MateuszKost/8buttonsQuizBuzzer/Dokumentacja końcowa/Readme.md

Mateusz Kost grupa 4, inf semestr 5

Projekt o nazwie „8 kanałowy dzwonek do quizu” posiadał poniższe założenia:
- informacja wciśniętym guziku (jego numer) będzie adekwatnie wyświetlana na wyświetlaczu
- w przypadku wciśnięcia dwóch guzików, minimalna różnica czasowa przy ich wciskaniu zostanie wychwycona przez program oraz informacja o szybciej wciśniętym guziku zostanie pokazana na wyświetlaczu
- po wychwyceniu wciśnięcia guzika, program wyśle sygnał do buzzera, który zadzwoni

Wersja finalna projektu spełnia wszystkie powyższe założenia, a do samego projektu dołożyłem jeszcze 3 diody sygnalizujące o adekwatnym stanie programu.

Funkcjonalność urządzenia opiera się na wciskaniu jednego z 8 guzików sterujących, a po wyświetleniu informacji na wyświetlaczu na temat wciśniętego guzika należy wcisnąć guzik reset, który wysyła informacje do programu aby zresetował wyświetlacz i pozwolił na ponowną możliwość wciśnięcia guzika sterującego.
