MateuszKost/8buttonsQuizBuzzer/Dokumentacja końcowa/CHANGELOG.md

12 listopada - pierwsza wersja projektu

12 grudnia - zmiana guzików 2 pinowych na 4

20 stycznia- dodanie diód o kolorach: zielony, żółty, czerwony, które sygnalizują o aktualnym stanie programu
