MateuszKost/8buttonsQuizBuzzer/Dokumentacja końcowa/Hardware/PDF/Mateusz.Kost_brd.pdf

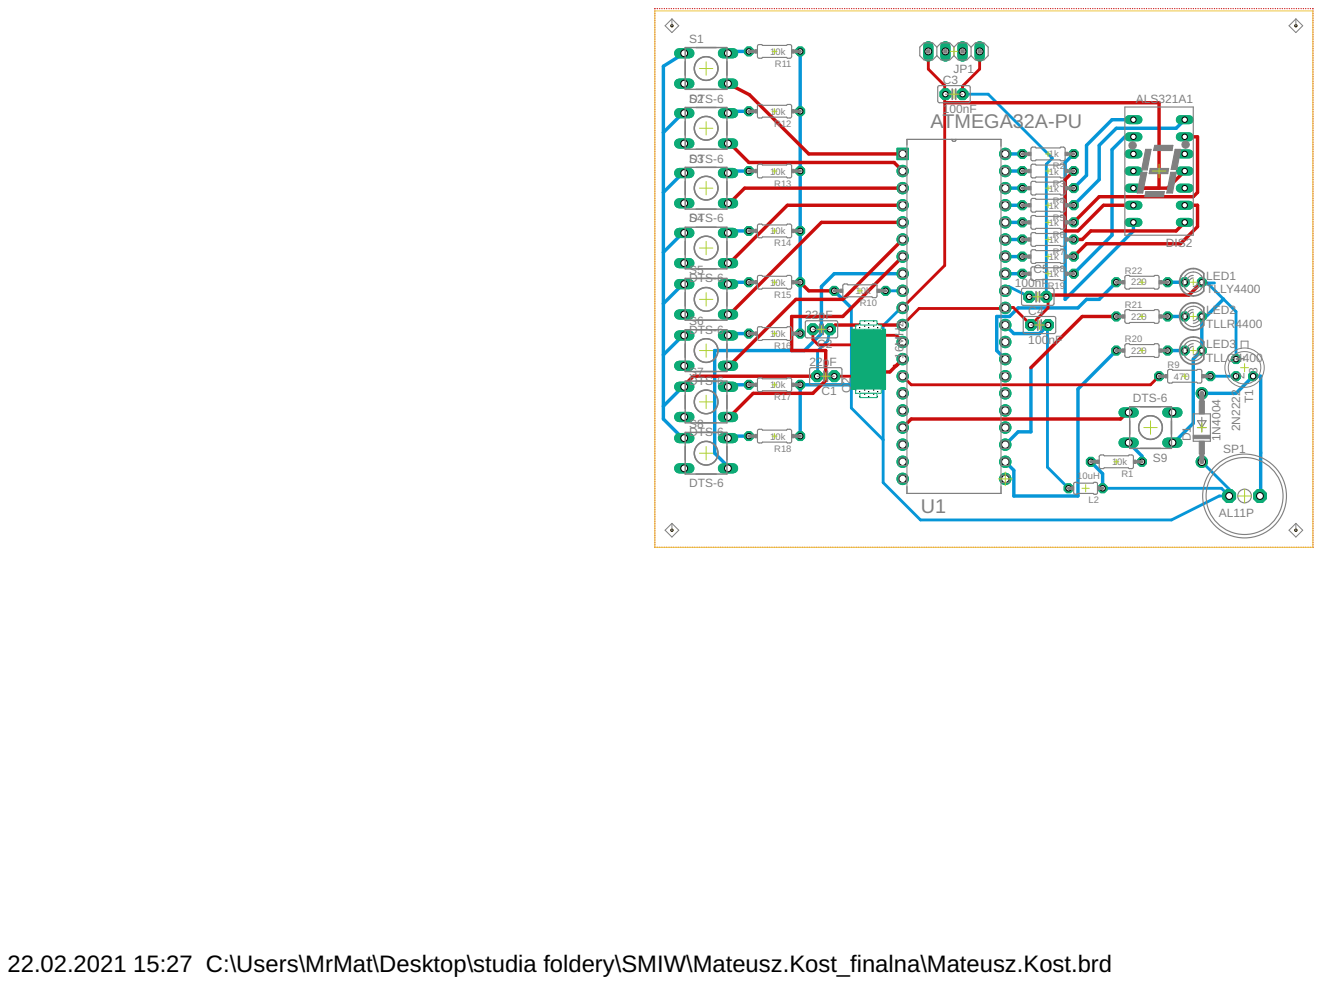
[picture p8: page 1]

DTS-6 DTS-6 DTS-6 DTS-6

22.02.2021 15:27 C:\Users\MrMat\Desktop\studia foldery\SMIW\Mateusz.Kost_finalna\Mateusz.Kost.brd
