MateuszKost/8buttonsQuizBuzzer/Dokumentacja końcowa/Hardware/PDF/Mateusz.Kost_sch.pdf

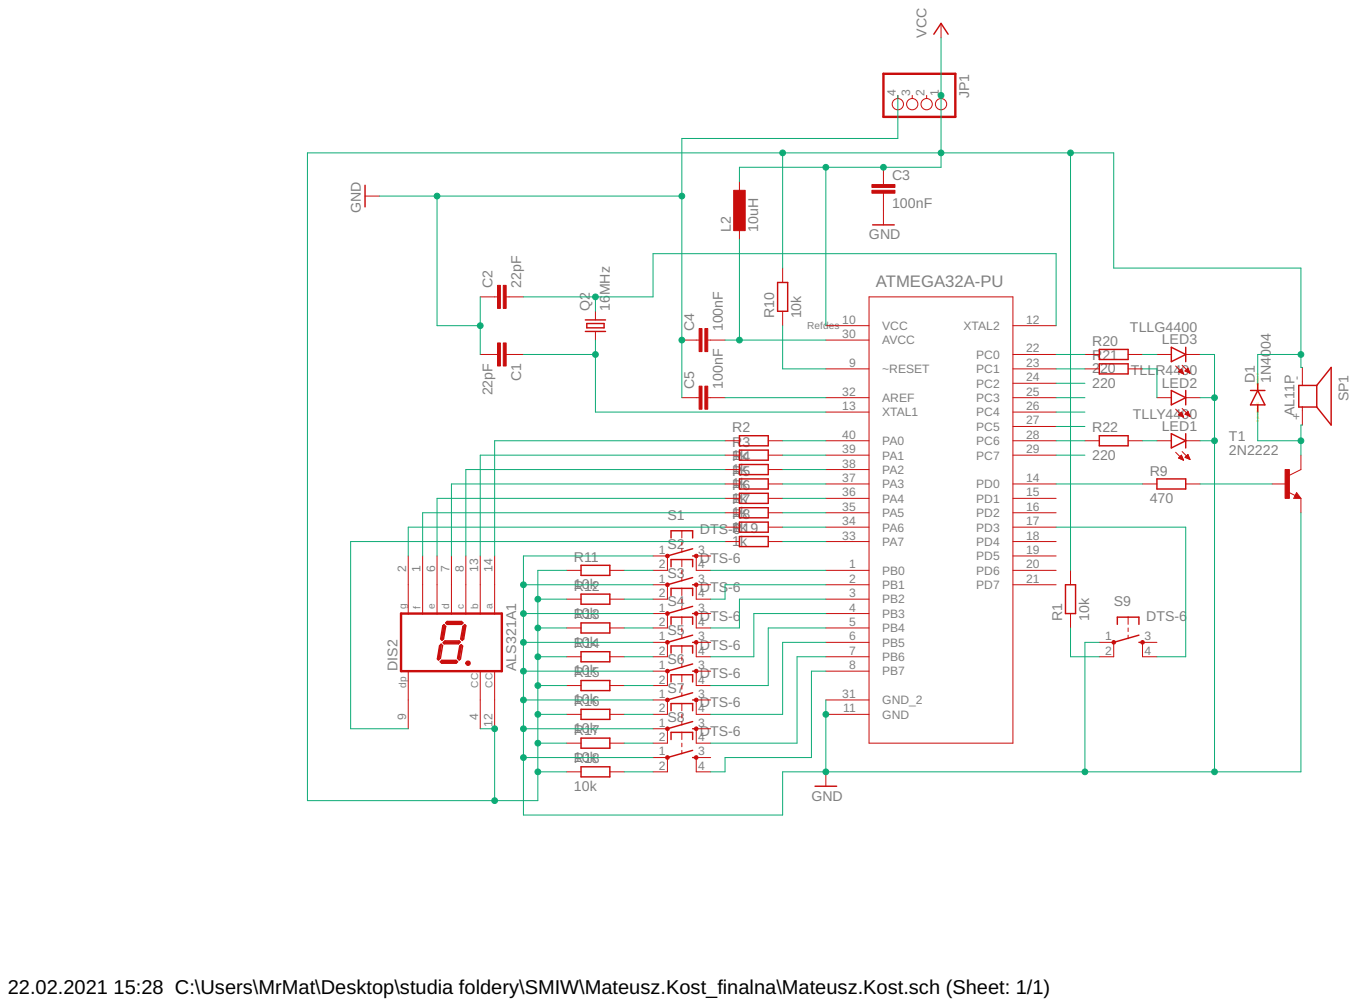
[picture p9: page 1]

1k R4 | 29 PD0
R5 1k
R6 1k | 14 PD1 15 PD2

22.02.2021 15:28 C:\Users\MrMat\Desktop\studia foldery\SMIW\Mateusz.Kost_finalna\Mateusz.Kost.sch (Sheet: 1/1)
