MateuszKost/8buttonsQuizBuzzer/Dokumentacja końcowa/Hardware/Eagle/Mateusz.Kost.brd

## EAGLE design Dokumentacja końcowa/Hardware/Eagle/Mateusz.Kost.brd (2021-06-03)

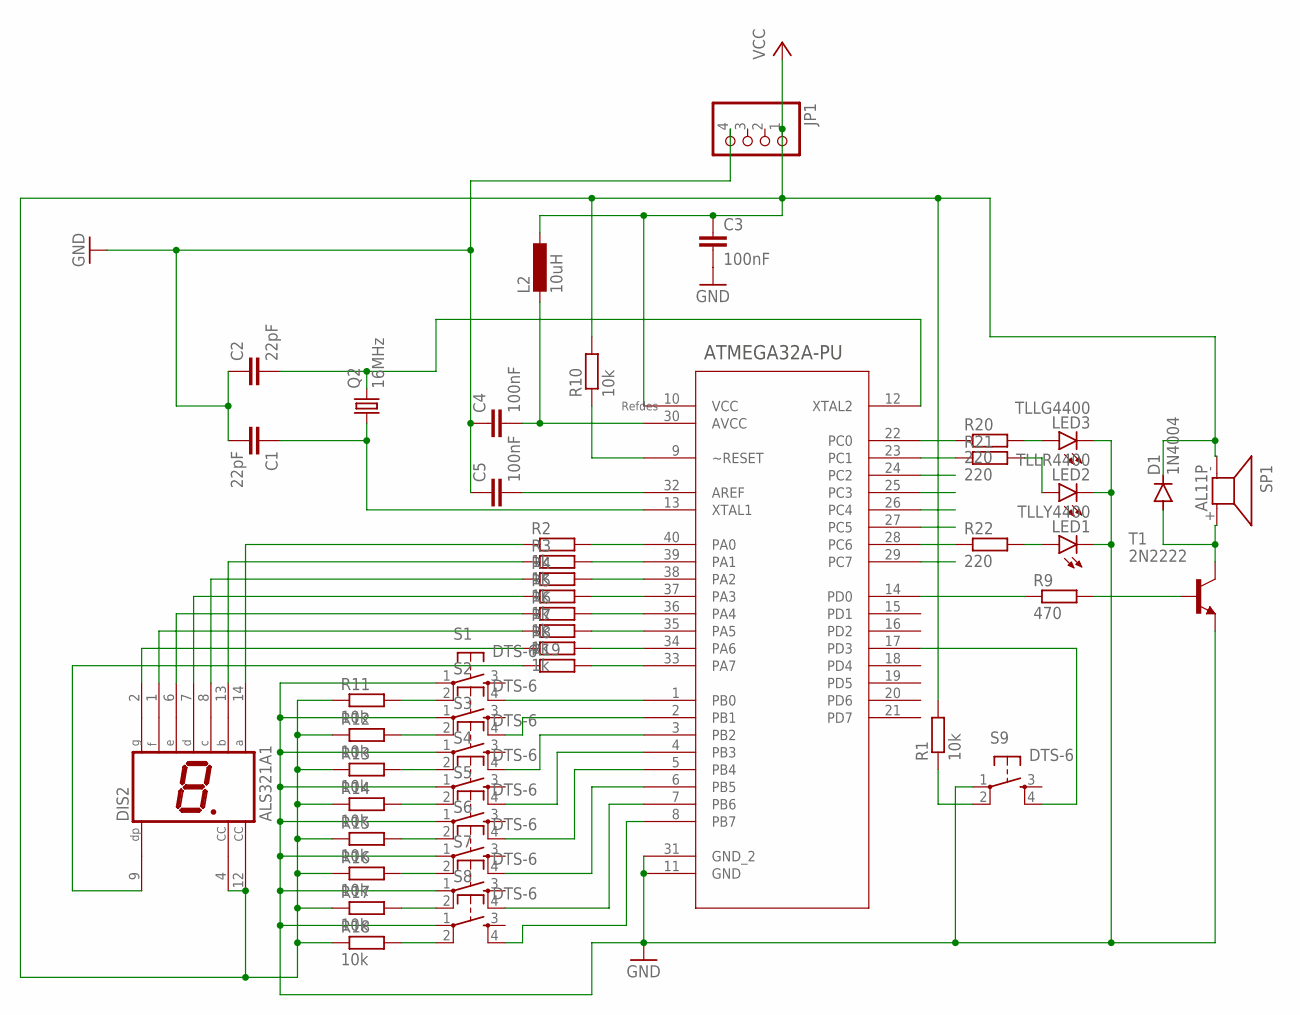
[picture p21: schematic Mateusz.Kost.sch]

Parts:
C1, C2: 22pF; C2.5-2
C3, C4, C5: 100nF; C2.5-2
D1: 1N4004; DO41-10
DIS2: ALS321A1
JP1: PINHD-1X4; 1X04
L2: 10uH; 0204/5
LED1: TLLY4400; LED3MM
LED2: TLLR4400; LED3MM
LED3: TLLG4400; LED3MM
Q2: 16MHz; HC49/S
R1, R10, R11, R12, R13, R14, R15, R16, R17, R18: 10k; 0204/7
R2, R3, R4, R5, R6, R7, R8, R19: 1k; 0204/7
R9: 470; 0204/7
R20, R21, R22: 220; 0204/7
S1, S2, S3, S4, S5, S6, S7, S8, S9: DTS-6
SP1: AL11P
T1: 2N2222; TO18
U1: ATMEGA32A-PU; DIP254P1524X482-40

Connections:
GND: C1.2, C2.1, C3.2, C4.1, C5.1, JP1.4, LED1.K (C), LED2.K (C), LED3.K (C), S1.1, S2.1, S3.1, S4.1, S5.1, S6.1, S7.1, S8.1, S9.1, T1.1 (E), U1.11 (GND), U1.31 (GND_2)
unnamed: R9.1, U1.14 (PD0)
unnamed: R1.1, S9.2
unnamed: R11.2, S1.2
unnamed: S1.4, U1.1 (PB0)
unnamed: S2.4, U1.2 (PB1)
unnamed: S3.4, U1.3 (PB2)
unnamed: S4.4, U1.4 (PB3)
unnamed: S5.4, U1.5 (PB4)
unnamed: S6.4, U1.6 (PB5)
unnamed: R20.1, U1.22 (PC0)
unnamed: LED2.A, R21.2
unnamed: LED1.A, R22.2
unnamed: S7.4, U1.7 (PB6)
unnamed: R12.2, S2.2
unnamed: R13.2, S3.2
unnamed: R14.2, S4.2
unnamed: R15.2, S5.2
unnamed: R16.2, S6.2
unnamed: R17.2, S7.2
unnamed: R18.2, S8.2
unnamed: C2.2, Q2.2, U1.12 (XTAL2)
unnamed: R9.2, T1.2 (B)
unnamed: S9.4, U1.17 (PD3)
unnamed: D1.A, SP1.+ (2), T1.3 (C)
unnamed: C4.2, L2.2, U1.30 (AVCC)
unnamed: C5.2, U1.32 (AREF)
unnamed: R10.1, U1.9 (~RESET)
unnamed: C1.1, Q2.1, U1.13 (XTAL1)
unnamed: R2.2, U1.40 (PA0)
unnamed: R3.2, U1.39 (PA1)
unnamed: R4.2, U1.38 (PA2)
unnamed: R5.2, U1.37 (PA3)
unnamed: R6.2, U1.36 (PA4)
unnamed: R7.2, U1.35 (PA5)
unnamed: R8.2, U1.34 (PA6)
unnamed: R19.2, U1.33 (PA7)
unnamed: DIS2.14 (A), R2.1
unnamed: DIS2.13 (B), R3.1
unnamed: DIS2.8 (C), R4.1
unnamed: DIS2.7 (D), R5.1
unnamed: DIS2.6 (E), R6.1
unnamed: DIS2.1 (F), R7.1
unnamed: DIS2.2 (G), R8.1
unnamed: DIS2.9 (DP), R19.1
unnamed: LED3.A, R20.2
unnamed: R21.1, U1.23 (PC1)
unnamed: R22.1, U1.28 (PC6)
unnamed: S8.4, U1.8 (PB7)
VCC: C3.1, D1.C, DIS2.4 (CC), DIS2.12 (CC), JP1.1, L2.1, R1.2, R10.2, R11.1, R12.1, R13.1, R14.1, R15.1, R16.1, R17.1, R18.1, SP1.- (1), U1.10 (VCC)

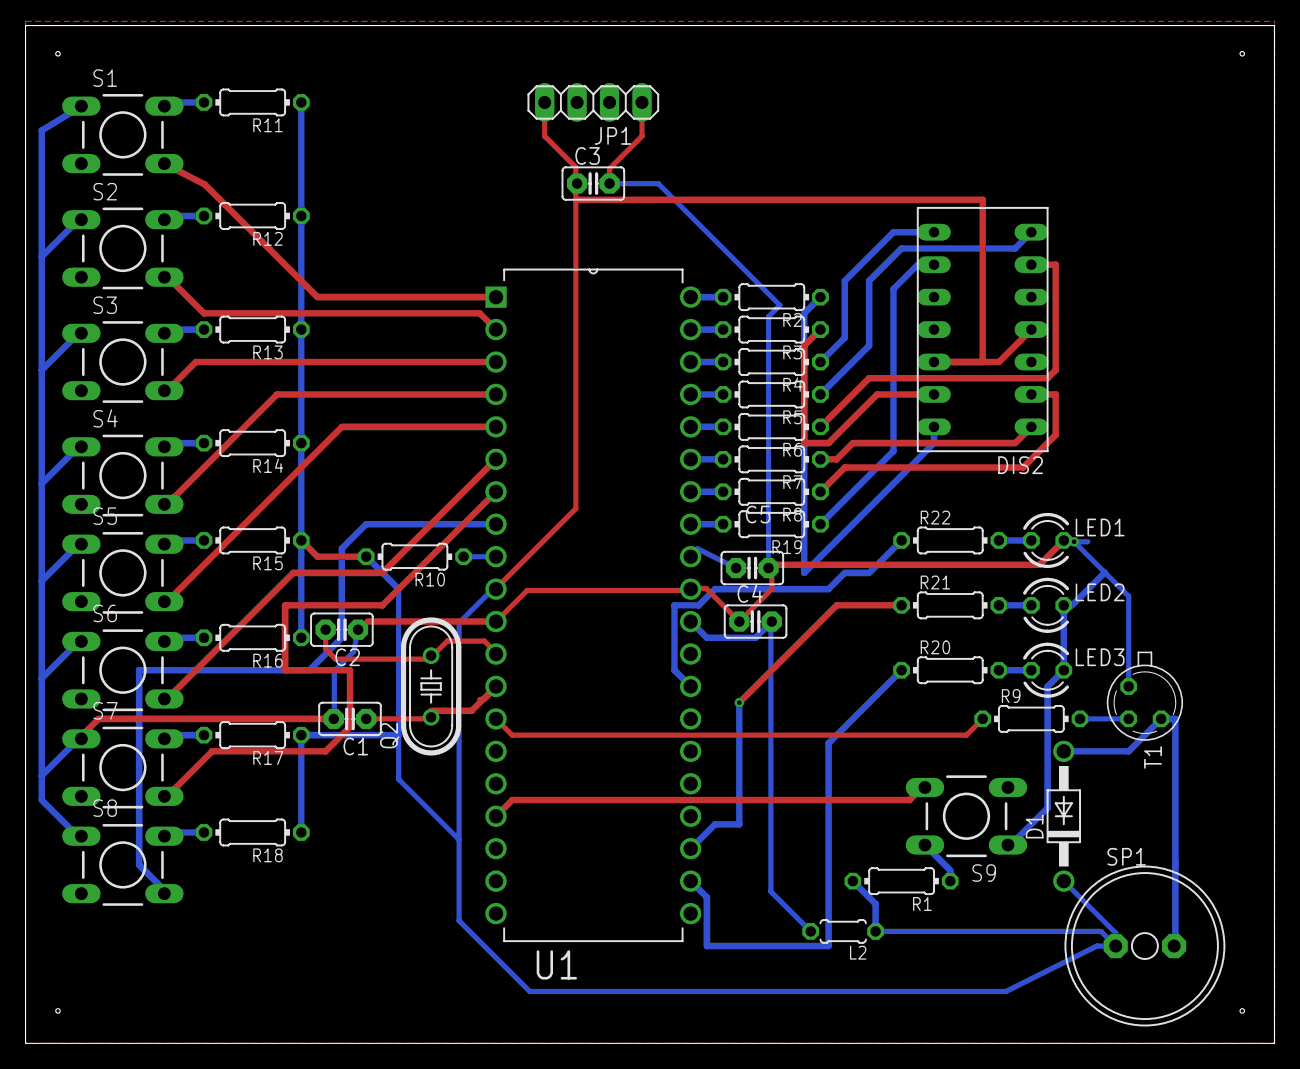
[picture p22: board Mateusz.Kost.brd from above]

Board: 2 copper layers, 97.8 x 79.7 mm, 47 parts (0 on the bottom side), 50 nets.
